viekeoleas/mini-bd1/mini-bd1-assembly.step

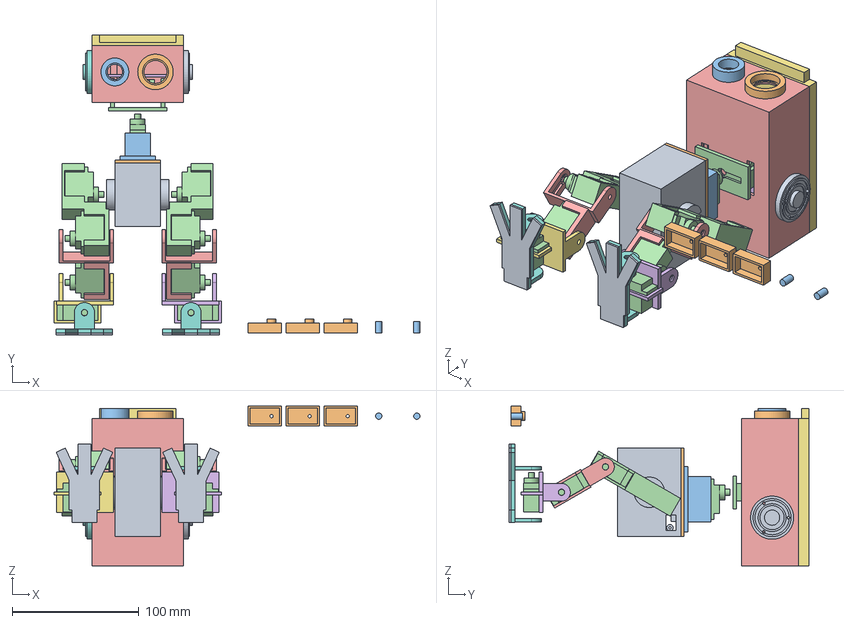
[picture p1: CAD file, 2026-10-07]
mini-bd1-assembly.step
288.5 x 236.3 x 125.9 mm
