viekeoleas/mini-bd1/print/P11_ankle_bracket_left_v06_x1.stl

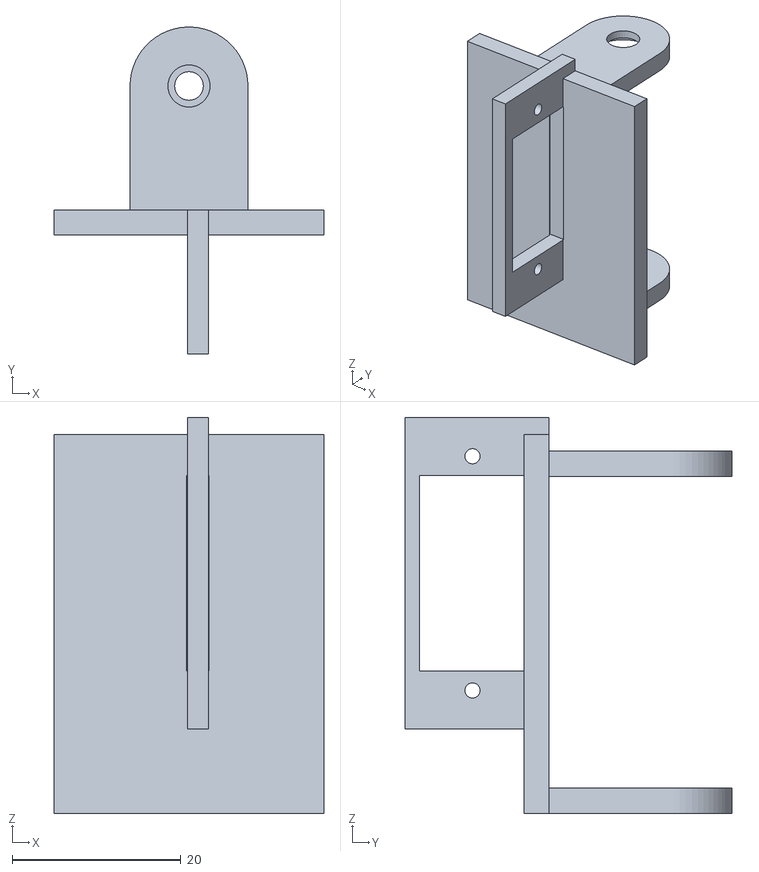
[picture p2: CAD file, 2026-10-19]
print/P11_ankle_bracket_left_v06_x1.stl
32.0 x 38.8 x 47.0
