viekeoleas/mini-bd1/print/P09_thigh_right_v03_x1.stl

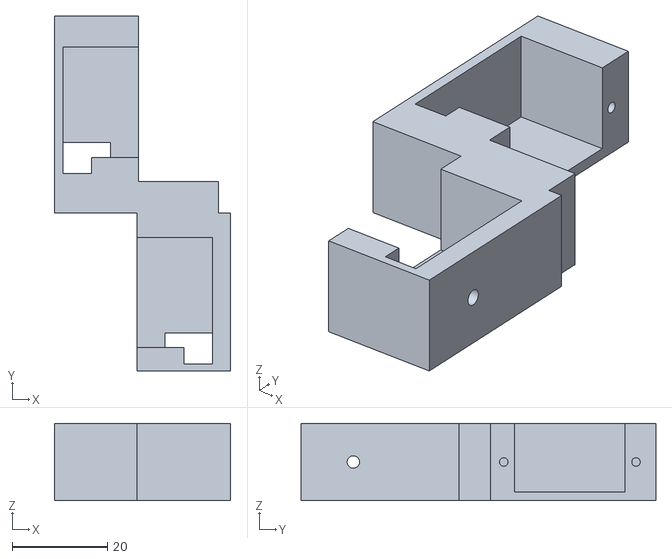
[picture p3: CAD file, 2026-10-19]
print/P09_thigh_right_v03_x1.stl
37.0 x 74.6 x 16.2
