viekeoleas/mini-bd1/print/P12_foot_v07_x2.stl

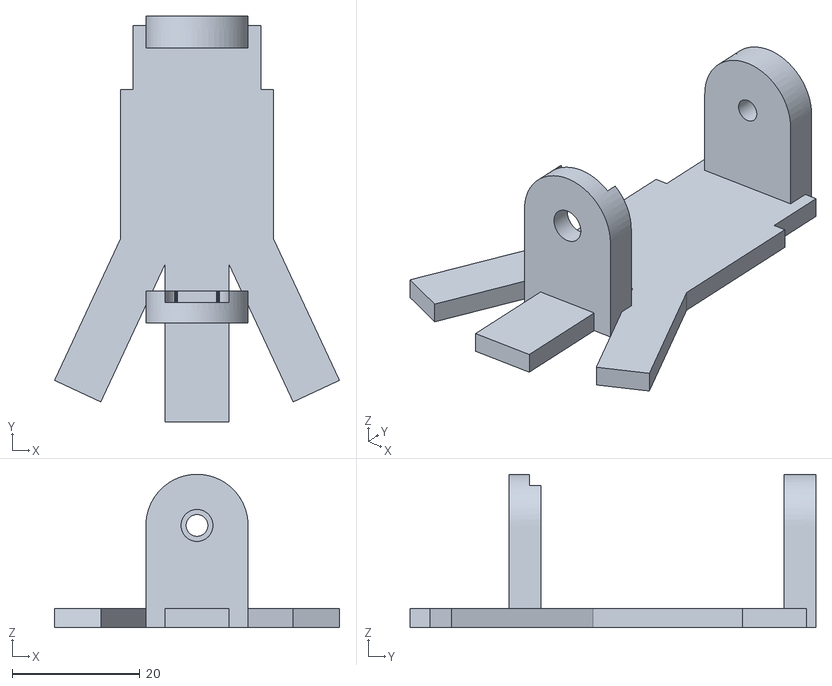
[picture p4: CAD file, 2026-10-19]
print/P12_foot_v07_x2.stl
44.6 x 63.5 x 24.0
