viekeoleas/mini-bd1/print/P02_pelvis_lid_v03_x1.stl

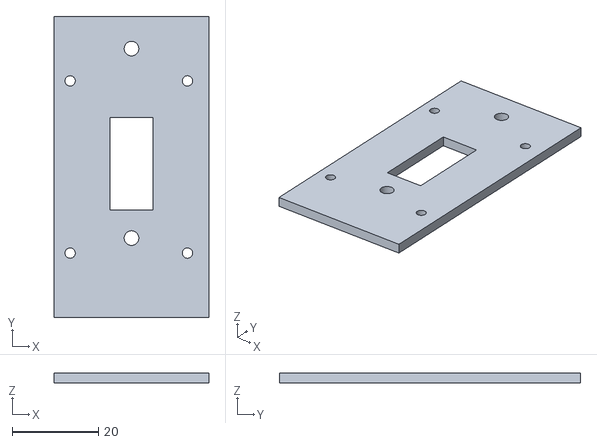
[picture p5: CAD file, 2026-10-19]
print/P02_pelvis_lid_v03_x1.stl
36.0 x 70.0 x 2.40
