viekeoleas/mini-bd1/print/P01_pelvis_v04_x1.stl

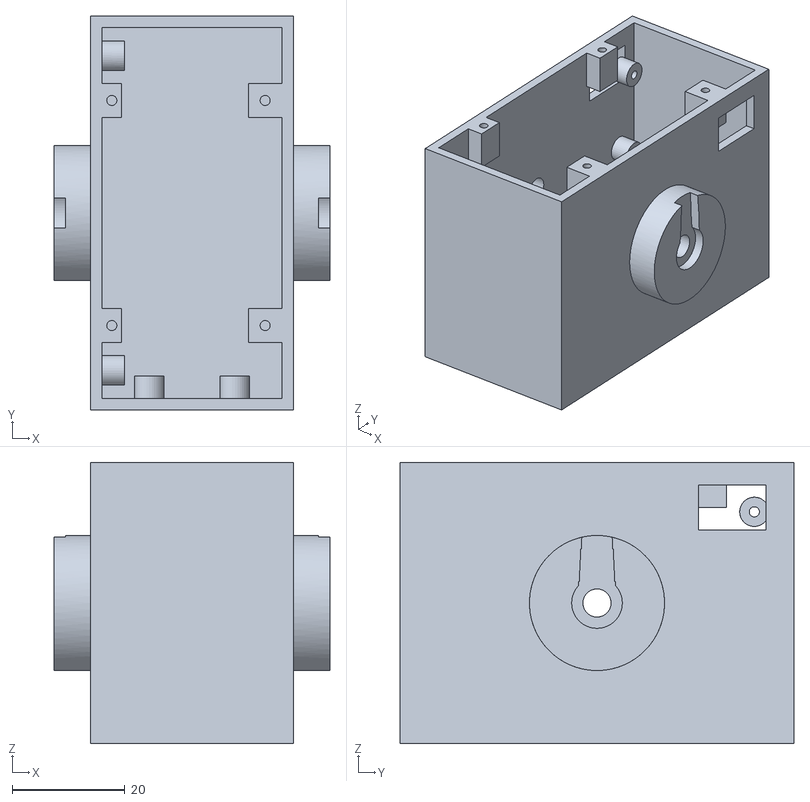
[picture p6: CAD file, 2026-10-19]
print/P01_pelvis_v04_x1.stl
49.0 x 70.0 x 50.0
