viekeoleas/mini-bd1/print/P04_neck_yoke_v07_x1.stl

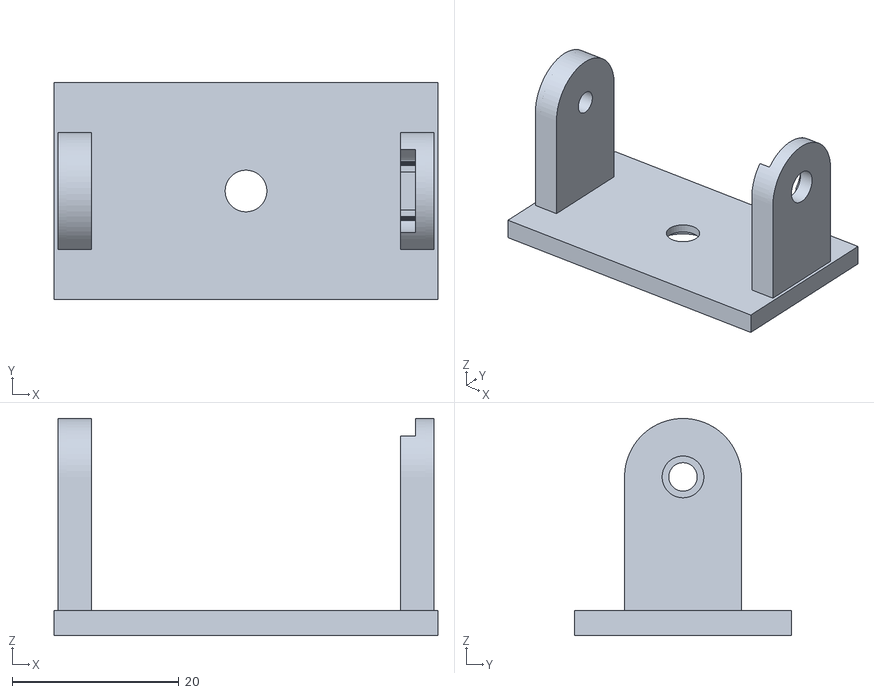
[picture p7: CAD file, 2026-10-19]
print/P04_neck_yoke_v07_x1.stl
46.0 x 26.0 x 26.0
