viekeoleas/mini-bd1/print/P10_shin_right_v05_x1.stl

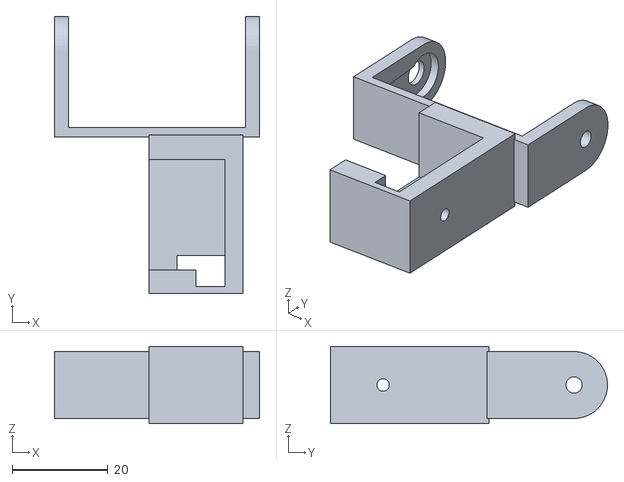
[picture p8: CAD file, 2026-10-19]
print/P10_shin_right_v05_x1.stl
43.0 x 58.0 x 16.2
