viekeoleas/mini-bd1/print/P14_pivot_cup_v05_x3.stl

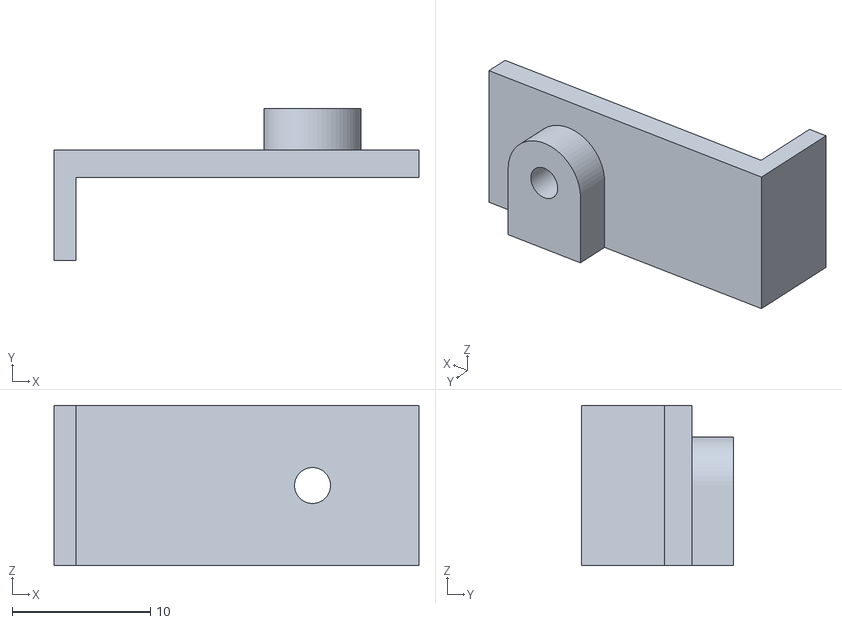
[picture p9: CAD file, 2026-10-19]
print/P14_pivot_cup_v05_x3.stl
26.4 x 11.0 x 11.6
