viekeoleas/mini-bd1/print/T01_horn_fit_test_x1.stl

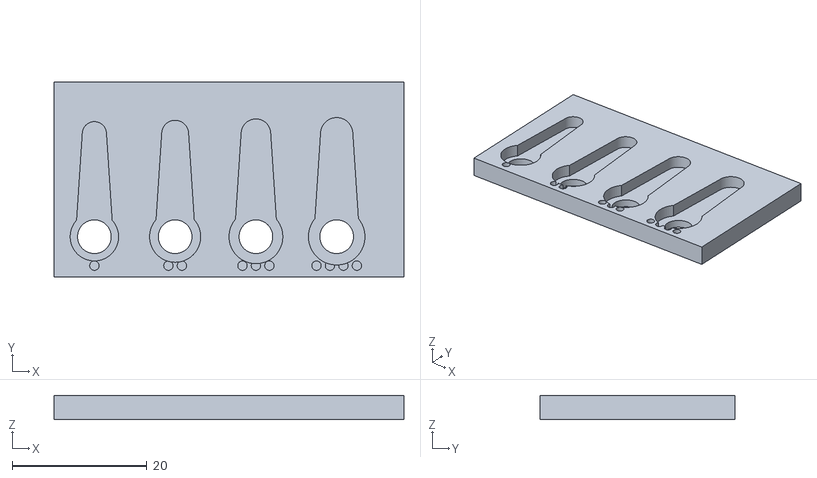
[picture p10: CAD file, 2026-10-19]
print/T01_horn_fit_test_x1.stl
52.0 x 29.0 x 3.60
