viekeoleas/mini-bd1/print/P03_neck_post_v03_x1.stl

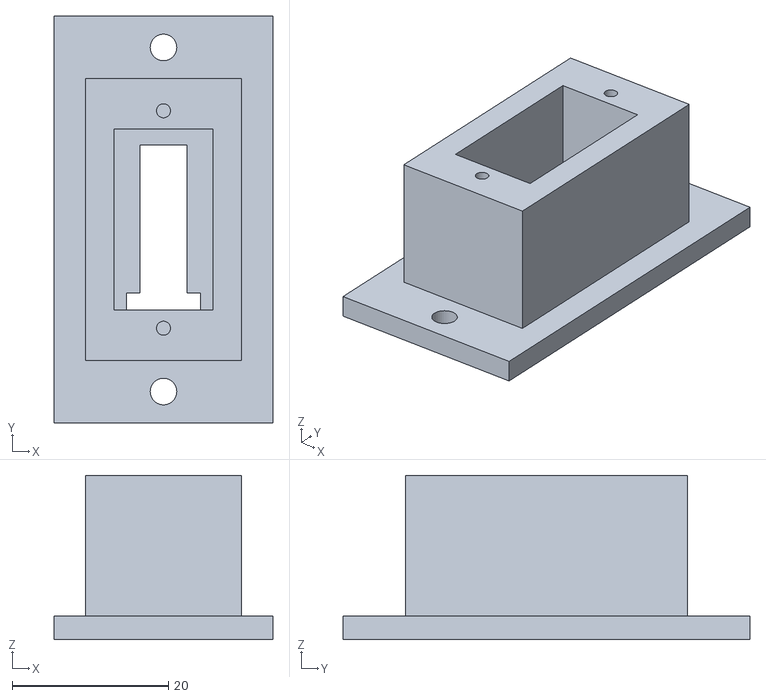
[picture p11: CAD file, 2026-10-19]
print/P03_neck_post_v03_x1.stl
28.0 x 52.0 x 21.0
