viekeoleas/mini-bd1/print/P13_sole_TPU_x2.stl

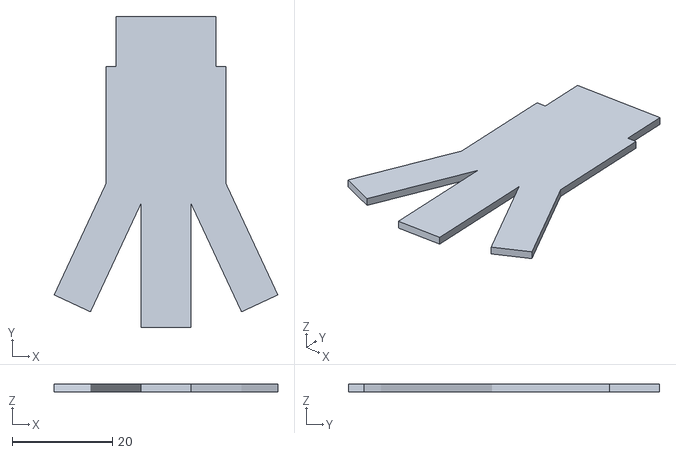
[picture p12: CAD file, 2026-10-07]
print/P13_sole_TPU_x2.stl
44.6 x 62.0 x 1.50
