viekeoleas/mini-bd1/print/P06_head_top_x1.stl

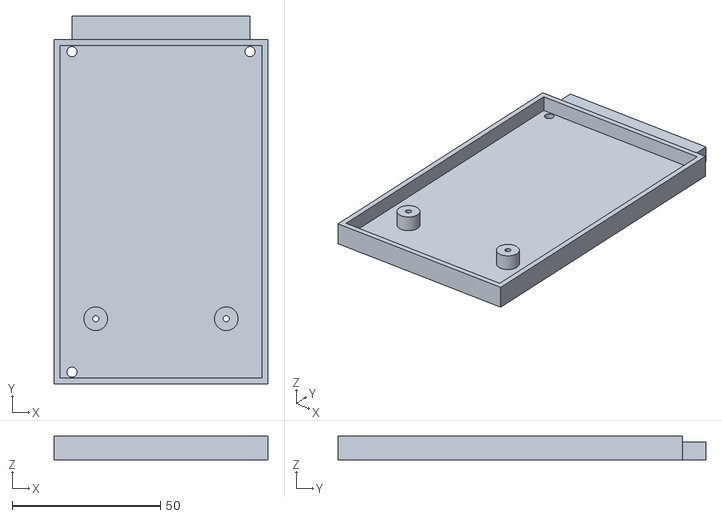
[picture p13: CAD file, 2026-10-07]
print/P06_head_top_x1.stl
72.0 x 124.0 x 8.00
