viekeoleas/mini-bd1/print/P07_side_disc_right_x1.stl

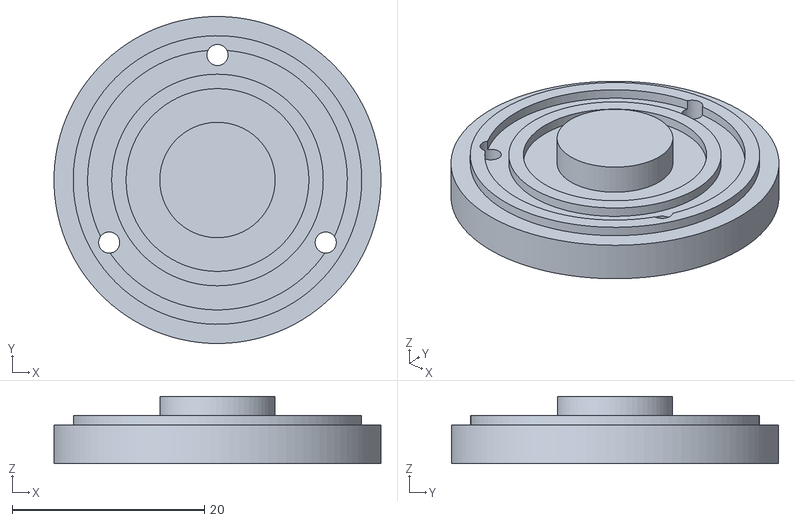
[picture p14: CAD file, 2026-10-07]
print/P07_side_disc_right_x1.stl
34.0 x 34.0 x 7.00
