viekeoleas/mini-bd1/print/P05b_battery_shelf_x1.stl

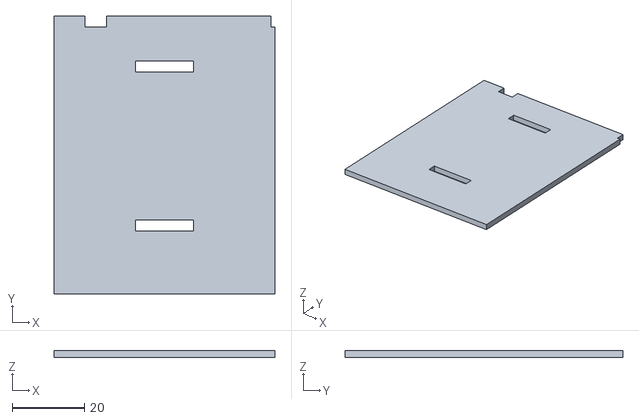
[picture p15: CAD file, 2026-10-07]
print/P05b_battery_shelf_x1.stl
61.2 x 77.0 x 2.00
