viekeoleas/mini-bd1/print/P15_antenna_tip_x2.stl

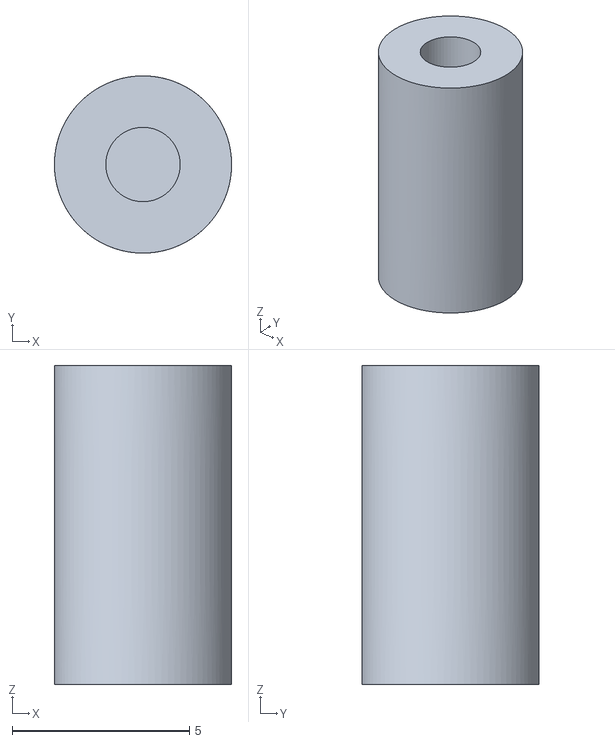
[picture p17: CAD file, 2026-10-07]
print/P15_antenna_tip_x2.stl
5.00 x 5.00 x 9.00
