viekeoleas/mini-bd1/print/P08_lamp_bezel_x1.stl

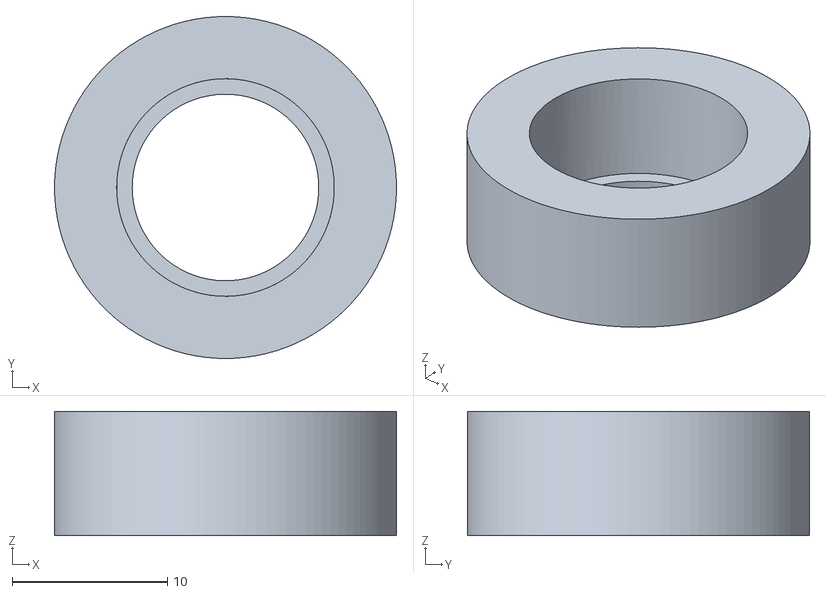
[picture p18: CAD file, 2026-10-07]
print/P08_lamp_bezel_x1.stl
22.0 x 22.0 x 8.00
