viekeoleas/mini-bd1/print/P08_eye_bezel_x1.stl

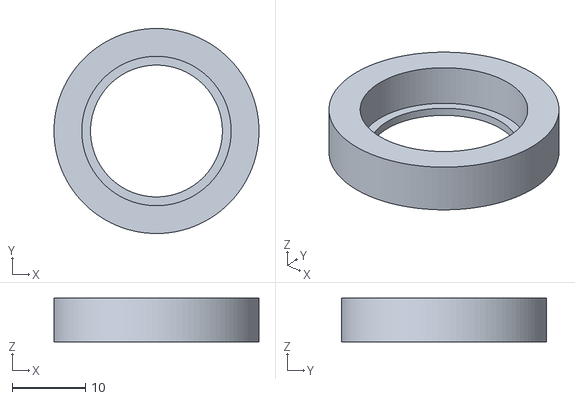
[picture p19: CAD file, 2026-10-07]
print/P08_eye_bezel_x1.stl
28.0 x 28.0 x 6.00
