viekeoleas/mini-bd1/print/P05_head_bottom_x1.stl

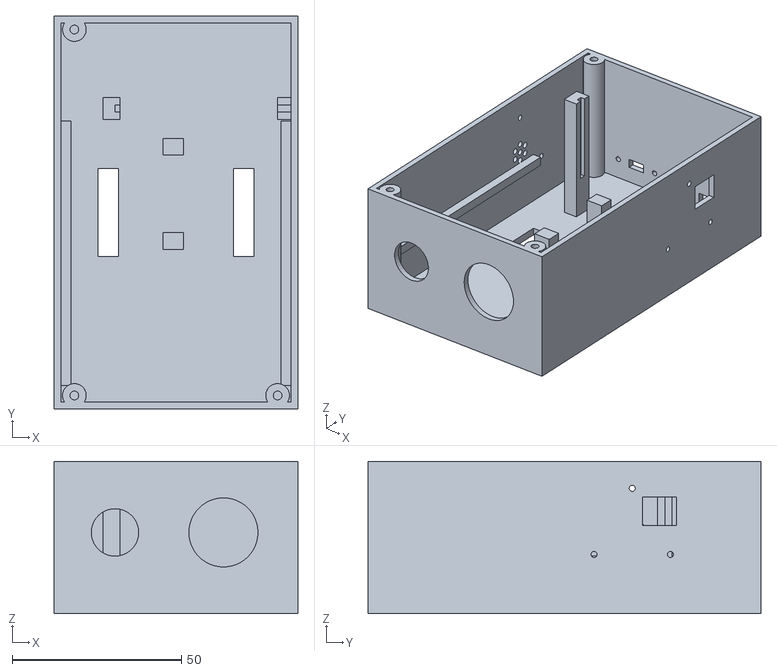
[picture p20: CAD file, 2026-10-07]
print/P05_head_bottom_x1.stl
72.0 x 116.0 x 45.0
