viekeoleas/mini-bd1/(list of files, cad)

Other CAD files:
print/P11_ankle_bracket_right_v06_x1.stl
print/P09_thigh_left_v03_x1.stl
print/P10_shin_left_v05_x1.stl
