viekeoleas/mini-bd1/print/README.md

# Мини BD-1 — файлы для печати (Bambu Lab A1 mini)

Версия 0.2, 7 октября 2026. Модель: Fusion, документ «Mini BD-1» (собран скриптом).
Все детали уже повёрнуты так, как их печатать: импортируй STL в Bambu Studio и **не поворачивай**.
Число в конце имени файла (`_x2`, `_x3`) — сколько штук печатать.

## Общие настройки

- Сопло 0,4, профиль **0.20 mm Standard**, PLA.
- Корпусные детали (таз, голова, диски): 3 стенки, 15% gyroid.
- Детали ног и шеи (бедра, голени, скобы, стопы, вилка, стойка шеи): **4 стенки, 30–40% gyroid** — они нагружены.
- Поддержки: только там, где указано. Тип — **tree (auto)**.
- Пластика всего около 170 г PLA и около 5 г TPU (оценка по объёму).

## Детали

| Файл | Шт | Пластик | Заполнение | Поддержки | Заметки |
|---|---|---|---|---|---|
| P01_pelvis_v04_x1 | 1 | PLA белый | 3 стенки, 20% | tree, только от стола | под бобышками крышки свесы 6 мм |
| P02_pelvis_lid_v03_x1 | 1 | PLA белый | 3 стенки, 20% | нет | |
| P03_neck_post_v03_x1 | 1 | PLA | 4 стенки, 30% | нет | |
| P04_neck_yoke_v07_x1 | 1 | PLA | 4 стенки, 40% | нет | нагружена, не экономить |
| P05_head_bottom_x1 | 1 | PLA белый | 3 стенки, 15% | нет | самая долгая деталь |
| P05b_battery_shelf_x1 | 1 | PLA | 3 стенки, 20% | нет | |
| P06_head_top_x1 | 1 | PLA белый | 3 стенки, 15% | нет | печатается верхом вниз, козырёк на столе |
| P07_side_disc_left_grille_x1 | 1 | PLA белый | 3 стенки, 20% | нет | с решёткой, ставится слева (там пищалка) |
| P07_side_disc_right_x1 | 1 | PLA белый | 3 стенки, 20% | нет | |
| P08_eye_bezel_x1 | 1 | PLA тёмно-серый | 100% | нет | оправа линзы Ø20 |
| P08_lamp_bezel_x1 | 1 | PLA тёмно-серый | 100% | нет | |
| P09_thigh_left_v03_x1, P09_thigh_right_v03_x1 | 1 + 1 | PLA | 4 стенки, 30% | нет | гнёзда серво открыты вверх |
| P10_shin_left_v05_x1, P10_shin_right_v05_x1 | 1 + 1 | PLA | 4 стенки, 30% | нет | |
| P11_ankle_bracket_left_v06_x1, _right_v06_x1 | 1 + 1 | PLA | 4 стенки, 40% | **tree** | лежит на боку, верхняя лапа нависает |
| P12_foot_v07_x2 | 2 | PLA | 4 стенки, 30% | нет | левая и правая одинаковые |
| P13_sole_TPU_x2 | 2 | **TPU** | 100% | нет | медленно, 20–30 мм/с; клеить к стопе |
| P14_pivot_cup_v05_x3 | 3 | PLA | 100% | нет | надеваются на дно серво: наклон головы и 2 стопы |
| P15_antenna_tip_x2 | 2 | PLA чёрный | 100% | нет | на пруток Ø2 |

## Раскладка по столам (180 × 180)

1. **Голова-низ + полка** (P05, P05b).
2. **Голова-верх + таз + крышка таза** (P06, P01, P02).
3. **Ноги:** 2 бедра, 2 голени, 2 стопы.
4. **Мелочь:** 2 скобы голеностопа (с поддержками), стойка и вилка шеи, 2 диска, 2 оправы, 3 чашки, 2 наконечника.
5. **TPU:** 2 подошвы.

Начни со стола 3 и одной ноги: так раньше всего проверим, что серво садятся в гнёзда.

## Перед печатью проверь штангенциркулем

Гнёзда рассчитаны на MG90S 22,8 × 12,2 мм с зазором 0,2 мм на сторону.
Если твои серво больше на 0,3 мм и сильнее — напиши размеры, перестрою модель.
Самое быстрое — сначала распечатать **P10_shin_left** и вставить серво.

## Крепёж

| Что | Шт | Куда |
|---|---|---|
| Саморезы из пакетика MG90S | 20 | ушки 10 серво |
| Саморез M2 × 6 | 12 | PCA9685 (4), MPU-6050 (2), боковые диски (6) |
| Саморез M2 × 8 | 4 | крышка таза |
| Саморез M3 × 6 | 4 | оси колен и голеностопов: вкручиваются в стенку бедра и голени |
| Саморез M3 × 8 | 3 | оси в опорные чашки: наклон головы и 2 стопы |
| Винт M3 × 10 + гайка | 2 | стойка шеи к крышке таза |
| Саморез M3 × 10 | 3 | верх головы |
| Маленькие саморезы | по 2 на качалку | качалки к деталям (обычно есть в пакетике серво) |

Отверстия под саморезы уже нужного диаметра: резьбу нарезать не нужно, винт врезается в пластик сам.

## v0.7 (17 октября 2026): стопа без разведения ушек

`P12_foot_v07`: ушки 5 мм вместо 3 (наращены наружу), гнездо качалки на переднем ушке открыто вверх до края. Серво с качалкой на валу и чашкой на дне опускается между ушками сверху — разводить ушки не нужно (в v06 они ломались по слою у основания). Проверено на модели: путь сверху свободен. Потом центральный винт спереди и M3 × 8 сзади.

`P04_neck_yoke_v07`: ушки вилки 4 мм вместо 3 (наружу, проходят в прорези головы), гнездо качалки наклона головы открыто вверх — голова с качалкой на валу серво опускается на вилку сверху (проверено на модели). Оба гнезда как в v06: кружок Ø10, плечо 7,6.

## v0.6 (17 октября 2026): скобы голеностопа

`P11_ankle_bracket_left/right_v06`: гнездо качалки ещё шире — кружок Ø10, плечо 7,6 мм у кружка (в v04 кружок приходилось расширять паяльником). `P12_foot_v06` — то же гнездо на переднем ушке стопы.

## v0.5 (16 октября 2026): голени

В `P10_shin_left/right_v05` гнездо качалки шире на 0,2 мм на сторону: кружок Ø9,4, плечо 7,2 мм у кружка. В остальных деталях гнёзда как в v0.4.

`P14_pivot_cup_v05`: старая закрытая чашка упиралась в верхнюю пластину скобы голеностопа (на модели 281 мм³ пересечения) и закрывала провод. Новая: дно не шире серво, одна торцевая стенка, торец с проводом открыт, штырь с плоским боком — печатается лёжа на этом боку, без поддержек. Клеить к дну серво.

## v0.4 (14 октября 2026): гнёзда под качалки по форме

В v0.2–0.3 гнездо под одноплечую качалку было прямым пазом 4,6 мм, а плечо качалки сужается от кружка к концу, и оно не влезало.
Размер подобран на пробной пластинке `T01_horn_fit_test_x1` (подошёл паз 4, кружок открыт ещё на 0,3 мм): кружок Ø9, плечо 6,8 мм у центра кружка и сужается к концу.

**Качалки укоротить кусачками до 12,5 мм от центра кружка** (отрезать конец с 2–3 крайними дырками). Целая качалка (~17,5 мм) длиннее ушек вилок: у стопы до перемычки всего 13 мм. Все гнёзда заканчиваются на 12,8 мм и не заходят в перемычки.

| Файл | Где гнездо |
|---|---|
| P01_pelvis_v04 | шайбы бёдер, 2 шт. |
| P04_neck_yoke_v04 | снизу (серво шеи) и сбоку (наклон головы) |
| P10_shin_left / right_v04 | наружное ушко вилки колена (+ отверстия под провод из v0.3) |
| P11_ankle_bracket_left / right_v04 | наружное ушко вилки голеностопа |
| P12_foot_v04 | переднее ушко |

## v0.3 (10 октября 2026): пазы под провода серво

У MG90S провод выходит у дна со стороны вала, а в v0.2 гнёзда были глухие, и провод упирался в стенку.
Перепечатать эти 7 файлов, остальные детали не менялись:

| Файл | Что добавлено |
|---|---|
| P09_thigh_left / right | у обоих гнёзд (бедро, колено): сквозное отверстие 10 × 4,5 мм в задней стенке вплотную к торцу со стороны вала + канал 6 мм у дна в торцевой стенке |
| P10_shin_left / right | то же у гнезда голеностопа |
| P03_neck_post | паз 9,5 × 5,5 мм вниз через дно и основание, у торца со стороны вала |
| P02_pelvis_lid | окно под шеей расширено до 10 мм и удлинено до паза стойки |
| P14_pivot_cup | вырез 6 мм в торцевой стенке от дна до края |

Через отверстия целиком проходит 3-контактный штекер (7,6 × 2,5 мм), проверено на модели.
Провод выходит назад, за ногу, и идёт вверх к прорезям в задней части таза.
Порядок: продеть штекер изнутри гнезда наружу, потом вставить серво.
Задняя стенка лежит на столе при печати, так что отверстие печатается без поддержек. Настройки те же.

В Bambu Studio детали в проекте хранятся копией: старые удалить со стола и добавить файлы заново.

## Что поменялось после модели (v0.2 против чертежей v0.1)

- Голова стала длиннее: **116 × 72 × 53 мм**. Плата ESP32 стоит вертикально у задней стенки, иначе разъёмы проводов не помещались. USB ESP32 — на правом боку, USB-C зарядки — сзади.
- Полка под аккумуляторы — отдельная деталь: внутренний мост во всю ширину головы иначе пришлось бы печатать на поддержках.
- Скоба голеностопа и серво стопы опущены на 4,8 мм: при сгибе голени её хвост задевал скобу. Робот подрос до **≈ 235 мм** до верха головы.
- Колени и голеностопы держатся на саморезах M3, вкрученных прямо в стенку бедра и голени. Опорные чашки нужны только в трёх местах.
- Проверено в Fusion: нет пересечений между деталями и с 10 сервоприводами в стойке и в 5 крайних позах (присед, прямая нога, наклон стопы ±20°, вынос ноги вперёд).

## Файлы рядом

- `../mini-bd1-assembly.step` — вся сборка вместе с макетами серво, если захочешь открыть в другой CAD-программе.
