viekeoleas/mini-bd1/(commit log)

2026-10-07 Мини BD-1 v0.2: модель, файлы для печати, симуляция
    Fusion-модель собрана скриптом cad/build_bd1.py, 21 STL для Bambu A1 mini
    с настройками печати, STEP всей сборки и HTML-страницы: симуляция
    10 серво, черновые чертежи и список покупок.
    [P01_pelvis_x1.stl, P02_pelvis_lid_x1.stl, P03_neck_post_x1.stl, P04_neck_yoke_x1.stl, P05_head_bottom_x1.stl, P05b_battery_shelf_x1.stl, P06_head_top_x1.stl, P07_side_disc_left_grille_x1.stl]
2026-10-19 Мини BD-1 v0.7: исправленные детали, прошивка ходьбы, пульт
    Детали (print/, история версий в print/README.md):
    - отверстия под штекер серво в бёдрах, голенях, стойке шеи (v03)
    - гнёзда под одноплечую качалку по форме, размер подобран на пробной пластинке T01 (v04-v06)
    - тонкая опорная чашка, не упирается в скобу голеностопа (v05)
    - стопа и вилка шеи: толще ушки, гнездо качалки открыто вверх — серво ставится свер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
    [P01_pelvis_v04_x1.stl, P01_pelvis_x1.stl, P02_pelvis_lid_v03_x1.stl, P02_pelvis_lid_x1.stl, P03_neck_post_v03_x1.stl, P03_neck_post_x1.stl, P04_neck_yoke_v07_x1.stl, P04_neck_yoke_x1.stl]
